moranski7/Comp-444-Project/README.md

# <h1>Comp-444-Project</h1>
<div>
<p>My project for Embedded/Robotic Programming (COMP 444) from Athabasca University. Students were required to design a completely autonmous robot that takes in at least one input from the environment and performed at least one physical function. Additionally students were required to only use the Arduino as their primary microcontroller. What the robot did and how it completed the task was left completely to the student.</p>
<br>
<p>My idea was to create a robot to help me with my hearing disability. As a result of my hearing disability I am unable to hear any high pitch sounds without some form of assistence. The robot was to detect high pitch noise, locate the origin of the noise and then alert me when found.</p>
</div>
<h2>Project Hardware</h2>
<br>
<h3>FIRST HALF</h3>
  <div>
  <ul style="list-style-type:none;">
    <li>1x Arduino/Genuino Uno</li>
    <li>1x Sparkfun baseplate</li>
    <li>1x Motor driver</li>
    <li>2x Gear motors</li>
    <li>2x Wheels</li>
    <li>14x jumper wires</li>
    <li>1x battery holder</li>
    <li>4x AA batteries</li>
    <li>1x Dual lock tape</li>
  </ul>
  </div>
  <h3>SECOND HALF</h3>
  <div>
  <ul style="list-style-type:none;">
    <li>1x Arduino/Genuino Uno</li>
    <li>1x Switch</li>
    <li>2x LED</li>
    <li>3x 330 Ohm resistor</li>
    <li>1x LM 386 Sound Sensor</li>
    <li>1x Adafruit Electret Microphone Amplifier - MAX4466 with Adjustable Gain</li>
    <li>12x Jumper Wires</li>
    <li>3x Male/Female Jumper Wires</li>
    <li>4x Jumper Wires</li>
  </ul>
  </div>
<br>
<h2>Setup</h2>
<div>
<p>The set up can be found in <a href="https://github.com/moranski7/Comp-444-Project/blob/master/Michael%20Oransi%202743708%20Project.pdf">Michael Oransi 2743708 Project.pdf</a></p>
  </div>
 <br>
<h2>Note</h2>
<div>
<p>The project make use of I2C_Anything library found at https://github.com/nickgammon/I2C_Anything.<p>
  </div>
<br>
<h2>What works</h2>
<div>
  <ul>
    <li>Sound detect</li>
    <li>movement behavoir</li>
    <li>PID feedback</li>
  </ul>
  </div>
