moranski7/Comp-444-Project/Code/Rough Work/Master/Master.ino

#include <Wire.h>

int x = 0;
void setup() {
  // Start the I2C Bus as Master
  Wire.begin ();
}

void loop() {
  Wire.beginTransmission (9); // transmitt to device #9
  Wire.write (x); // sends x
  Wire.endTransmission (); // stop transmitting
  x++;
  if (x > 5) x = 0; // reset x once it gets 6
  delay (500);
}
