moranski7/Comp-444-Project/Code/Rough Work/Slave/Slave.ino

#include <Wire.h>
int LED = 13;
int x = 0;

void setup() {
  // Define the LED pin as Output
  pinMode (LED, OUTPUT);
  // Start the I2C Bus as Slave on address 9
  Wire.begin(9);
  // Attach a function to trigger when something is received
  Wire.onReceive (receiveEvent);
  Serial.begin (9600);
}

void receiveEvent (int bytes) {
  x = Wire.read();  // Read one character from the I2C
}

void loop() {
  // If value received is 0 blink LED for 200 ms
  if (x == 0) {
    digitalWrite (LED, HIGH);
    delay (200);
    digitalWrite (LED, LOW);
    delay (200);
    Serial.println ("test 1");
    
  }
  // if value received is 3 blink LED for 400 ms
  if (x == 3) {
    digitalWrite (LED,HIGH);
    delay (400);
    digitalWrite (LED, LOW);
    delay (400);
    Serial.println ("Test 2");
  }
}
